blazecoding2009/cncoverride/hardware/kicad/cncoverride-carrier.kicad_pcb

## KiCad design hardware/kicad/cncoverride-carrier.kicad_pcb (2026-11-11)

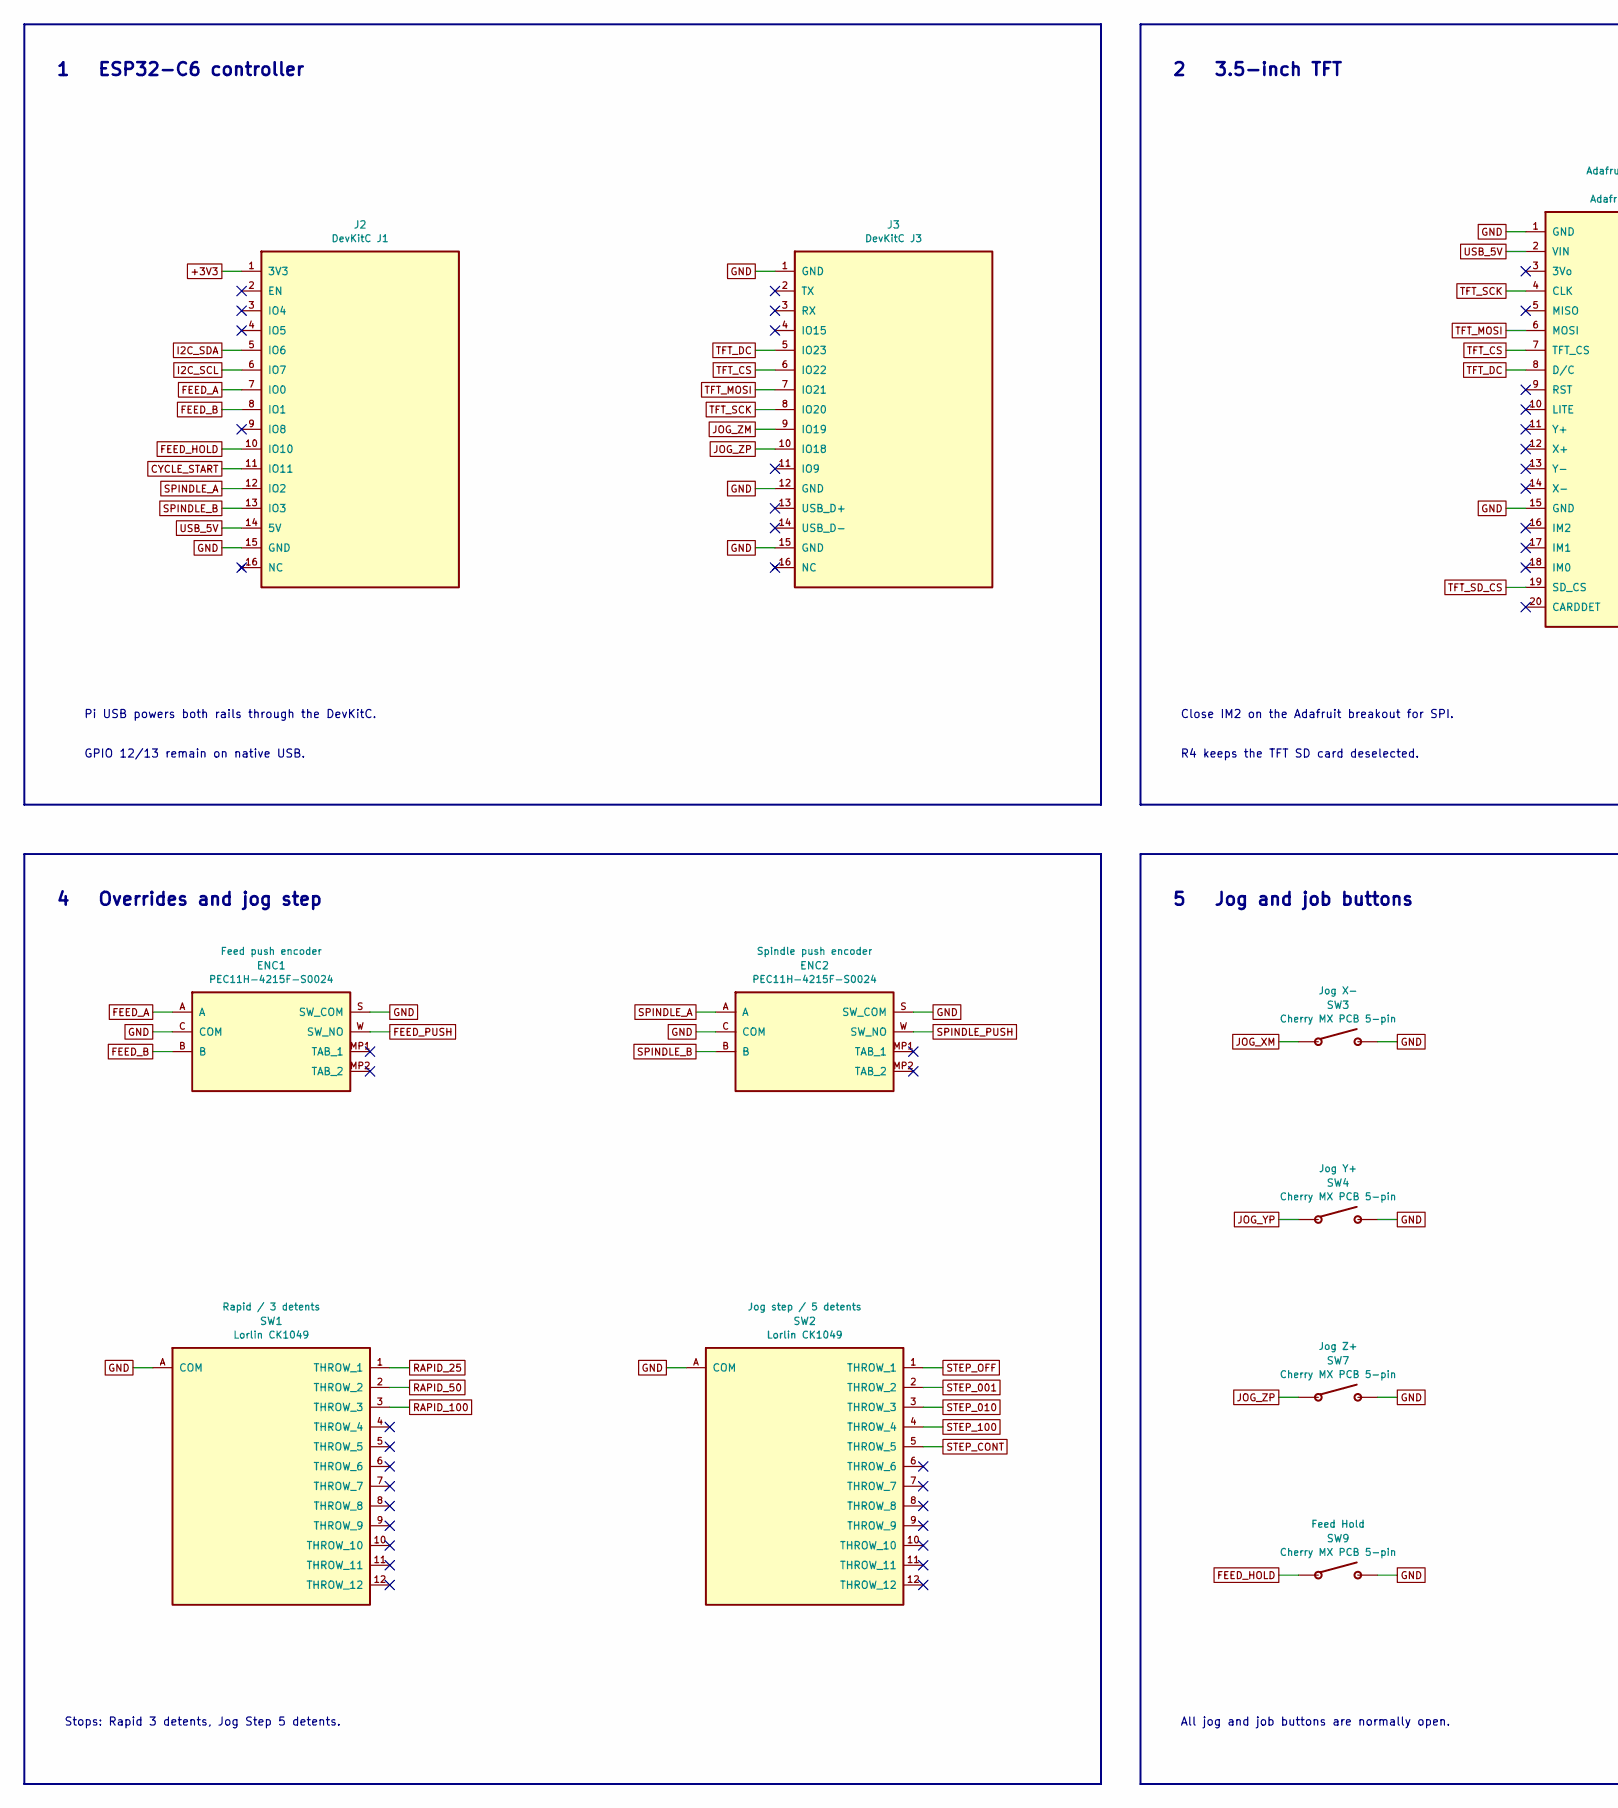
[picture p1: schematic cncoverride-carrier.kicad_sch, CNC Override Pendant, part in row 1, column 1]

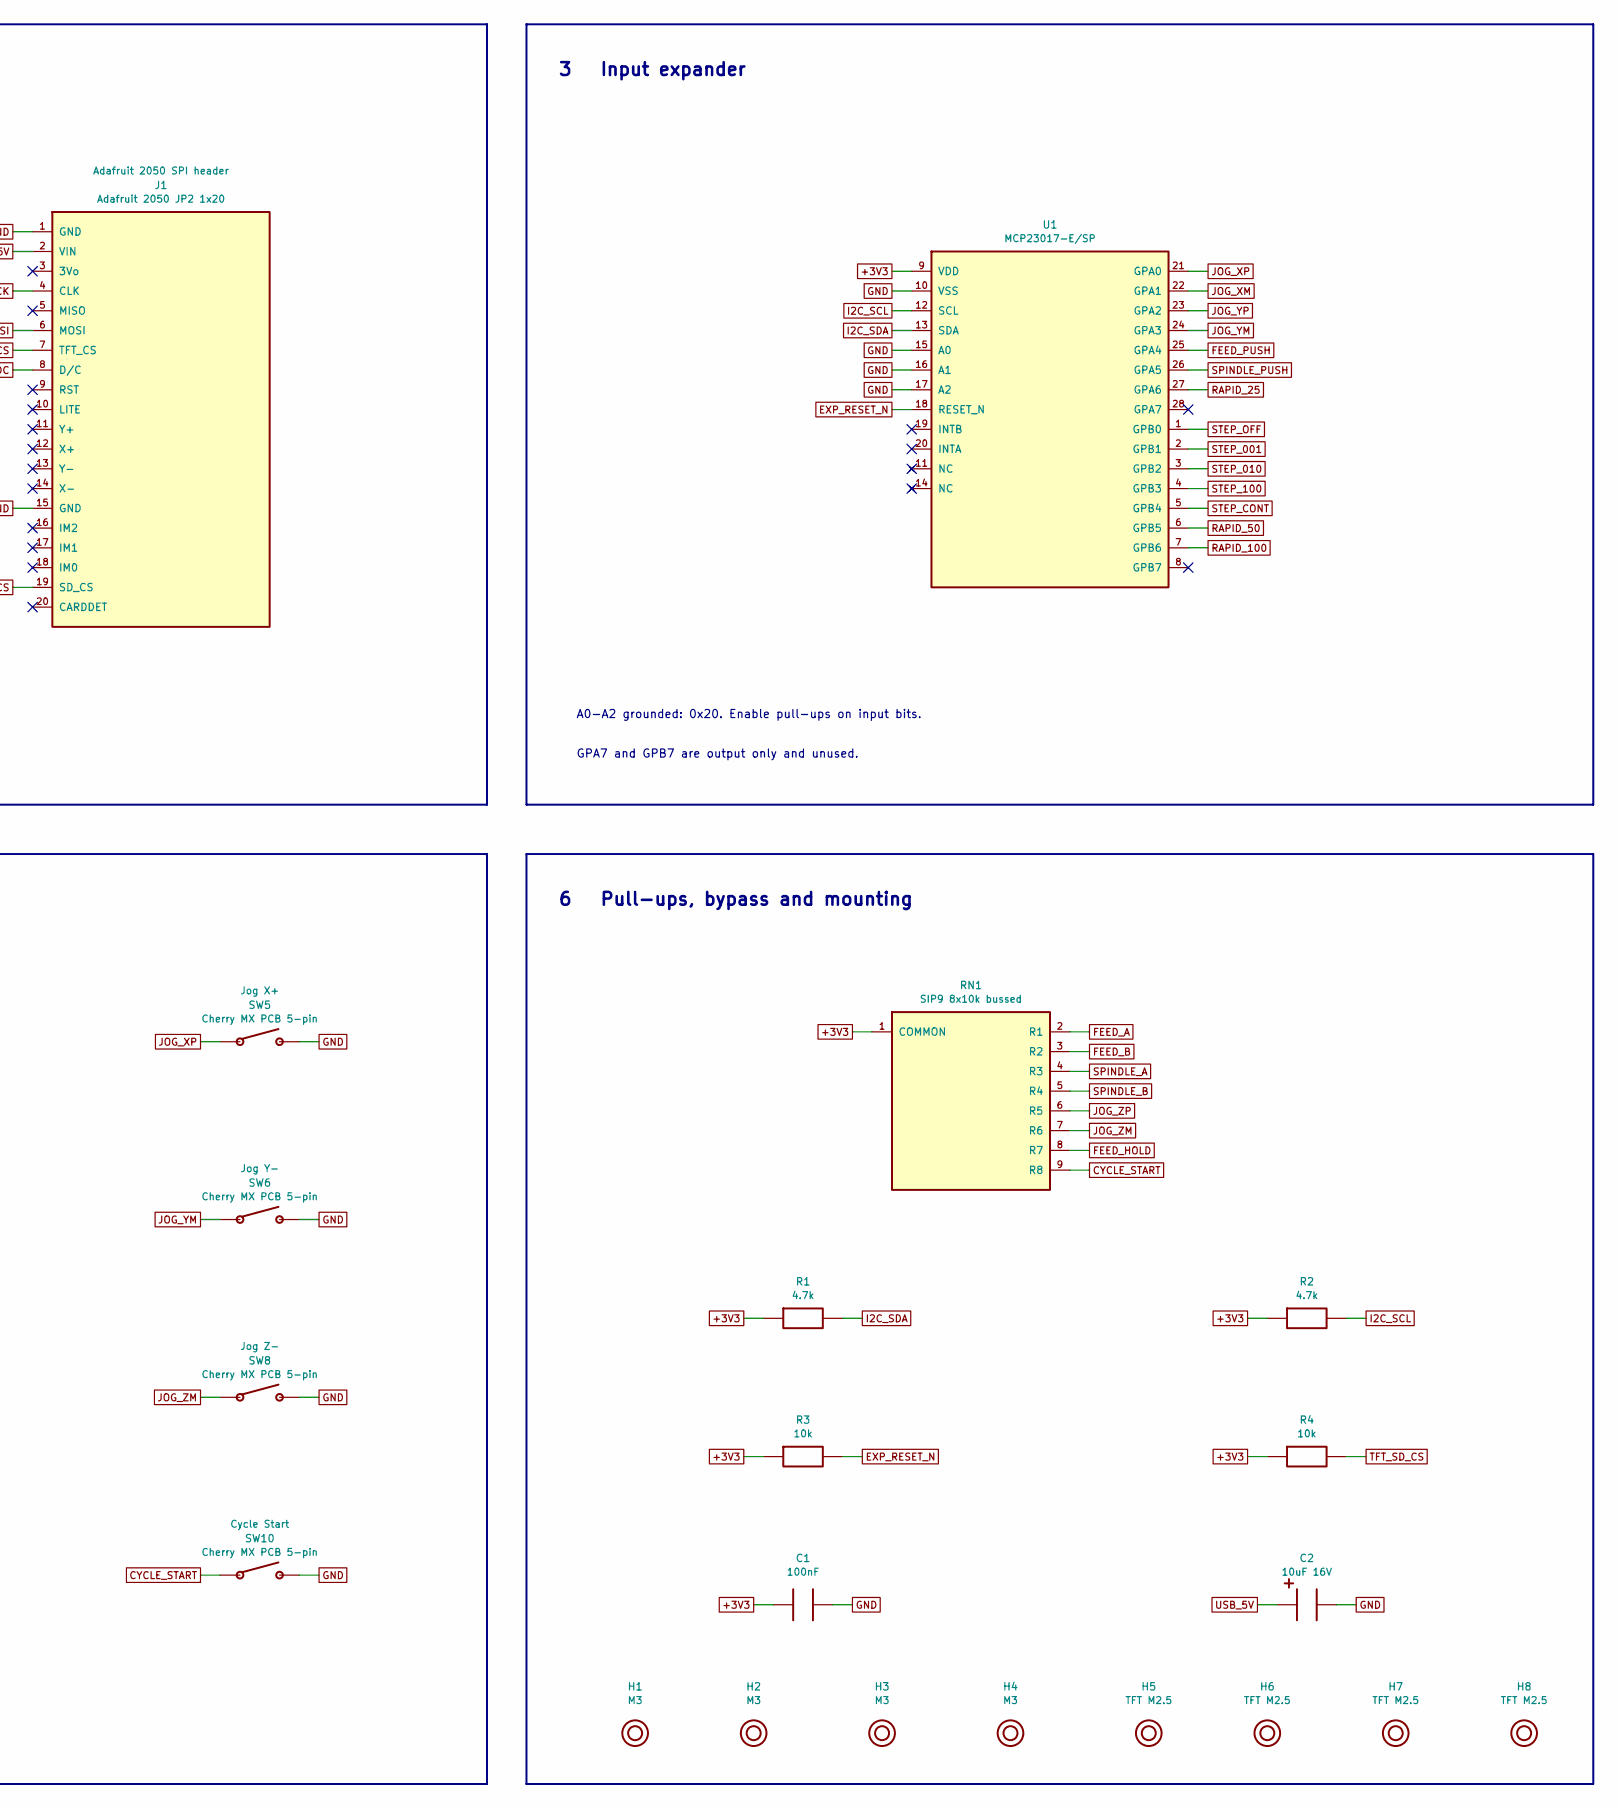
[picture p2: schematic cncoverride-carrier.kicad_sch, CNC Override Pendant, part in row 1, column 2]

Parts:
C1: 100nF; C_Disc_P2.50
C2: 10uF 16V; CP_D5_P2.00
ENC1, ENC2: PEC11H-4215F-S0024; Bourns_PEC11H-S
H1, H2, H3, H4: M3; MountingHole_3.2
H5, H6, H7, H8: TFT M2.5; MountingHole_2.7
J1: Adafruit 2050 JP2 1x20; Adafruit_2050_JP2_20
J2: DevKitC J1; Header_1x16
J3: DevKitC J3; Header_1x16
R1, R2: 4.7k; R_Axial_P7.62
R3, R4: 10k; R_Axial_P7.62
RN1: SIP9 8x10k bussed; SIP9_P2.54
SW1, SW2: Lorlin CK1049; Lorlin_CK_1P12T
SW3, SW4, SW5, SW6, SW7, SW8, SW9, SW10: Cherry MX PCB 5-pin; Cherry_MX_5pin
U1: MCP23017-E/SP; DIP28_7.62

Connections:
+3V3: C1.1, J2.1 (3V3), R1.1, R2.1, R3.1, R4.1, RN1.1 (COMMON), U1.9 (VDD)
CYCLE_START: J2.11 (IO11), RN1.9 (R8), SW10.1
EXP_RESET_N: R3.2, U1.18 (RESET_N)
FEED_A: ENC1.A, J2.7 (IO0), RN1.2 (R1)
FEED_B: ENC1.B, J2.8 (IO1), RN1.3 (R2)
FEED_HOLD: J2.10 (IO10), RN1.8 (R7), SW9.1
FEED_PUSH: ENC1.W (SW_NO), U1.25 (GPA4)
GND: C1.2, C2.2, ENC1.C (COM), ENC1.S (SW_COM), ENC2.C (COM), ENC2.S (SW_COM), J1.1 (GND), J1.15 (GND), J2.15 (GND), J3.1 (GND), J3.12 (GND), J3.15 (GND), SW1.A (COM), SW2.A (COM), SW3.2, SW4.2, SW5.2, SW6.2, SW7.2, SW8.2, SW9.2, SW10.2, U1.10 (VSS), U1.15 (A0), U1.16 (A1), U1.17 (A2)
I2C_SCL: J2.6 (IO7), R2.2, U1.12 (SCL)
I2C_SDA: J2.5 (IO6), R1.2, U1.13 (SDA)
JOG_XM: SW3.1, U1.22 (GPA1)
JOG_XP: SW5.1, U1.21 (GPA0)
JOG_YM: SW6.1, U1.24 (GPA3)
JOG_YP: SW4.1, U1.23 (GPA2)
JOG_ZM: J3.9 (IO19), RN1.7 (R6), SW8.1
JOG_ZP: J3.10 (IO18), RN1.6 (R5), SW7.1
RAPID_25: SW1.1 (THROW_1), U1.27 (GPA6)
RAPID_50: SW1.2 (THROW_2), U1.6 (GPB5)
RAPID_100: SW1.3 (THROW_3), U1.7 (GPB6)
SPINDLE_A: ENC2.A, J2.12 (IO2), RN1.4 (R3)
SPINDLE_B: ENC2.B, J2.13 (IO3), RN1.5 (R4)
SPINDLE_PUSH: ENC2.W (SW_NO), U1.26 (GPA5)
STEP_001: SW2.2 (THROW_2), U1.2 (GPB1)
STEP_010: SW2.3 (THROW_3), U1.3 (GPB2)
STEP_100: SW2.4 (THROW_4), U1.4 (GPB3)
STEP_CONT: SW2.5 (THROW_5), U1.5 (GPB4)
STEP_OFF: SW2.1 (THROW_1), U1.1 (GPB0)
TFT_CS: J1.7 (TFT_CS), J3.6 (IO22)
TFT_DC: J1.8 (D/C), J3.5 (IO23)
TFT_MOSI: J1.6 (MOSI), J3.7 (IO21)
TFT_SCK: J1.4 (CLK), J3.8 (IO20)
TFT_SD_CS: J1.19 (SD_CS), R4.2
USB_5V: C2.1, J1.2 (VIN), J2.14 (5V)

Notes on the sheet:
5 Jog and job buttons
Close IM2 on the Adafruit breakout for SPI.
2 3.5-inch TFT
4 Overrides and jog step
1 ESP32-C6 controller
R4 keeps the TFT SD card deselected.
GPIO 12/13 remain on native USB.
Pi USB powers both rails through the DevKitC.
Stops: Rapid 3 detents, Jog Step 5 detents.
6 Pull-ups, bypass and mounting
All jog and job buttons are normally open.
GPA7 and GPB7 are output only and unused.
3 Input expander
A0-A2 grounded: 0x20. Enable pull-ups on input bits.

Board: 2 copper layers, 31 parts (10 on the bottom side), 33 nets, no tracks yet.
